amaddi25/line-follower/docs/README.md

# R4D5 Line-Following Astromech
### Collaborators: Ayush Kakkanat & Akanksha Maddi

Click [here](https://Ayush17318.github.io/line-follower/) for the website version.

This is the summarized documentation for the R4D5 robot and will discuss the process, logic, and tools used. The project was completed in a span of 5 weeks and has the following functions to execute:
- Linear line tracking
- Turn various sized curves
- Not be affected by line breaks
- Not be affected by intersections
- Avoid obstacles
- Stop in an end-zone
- Find its way back to the start-zone
  
The goal of the project was for the robot to navigate any track with the above stated elements arranged in a randomized order with sufficient speed and reliability.

The following links will discuss the hardware, electronics, software, and analysis involved with building the robot pictured below.
- [Hardware & Design](hardware-and-design.md)
- [Electronics](electronics.md)
- [Software](software.md)
- [Analysis](analysis.md)

put in naked romi and r4d5 romi photos
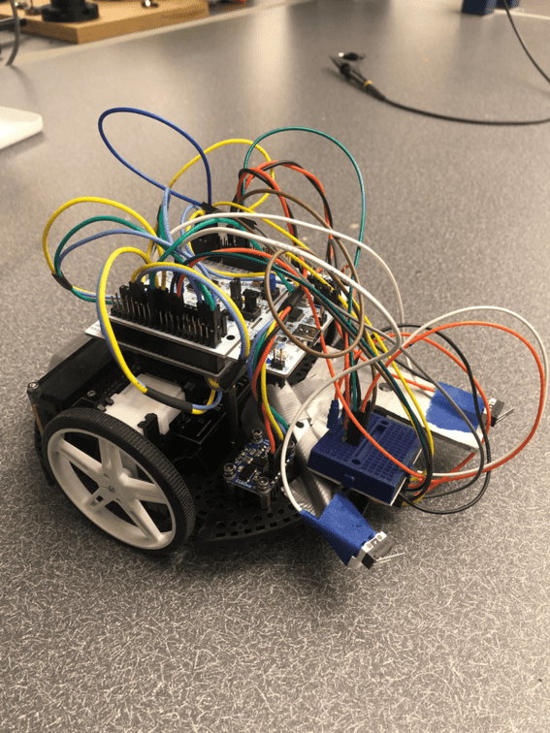
[picture p1: docs/assets/images/naked_romi.png]


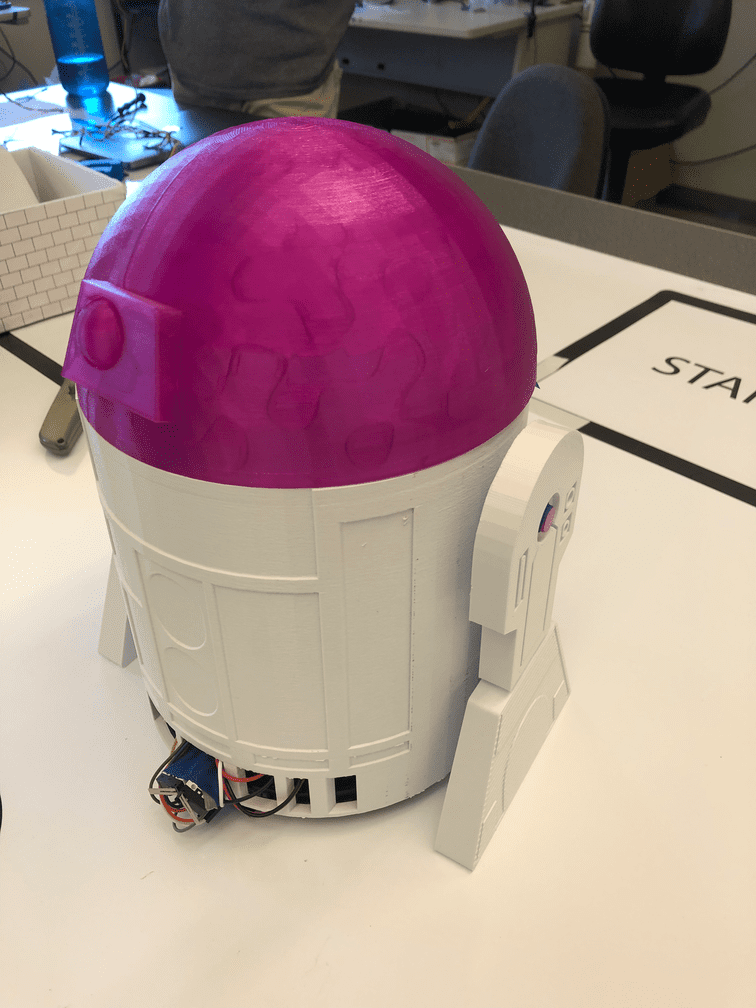
[picture p2: docs/assets/images/r4d5_isometric.png]


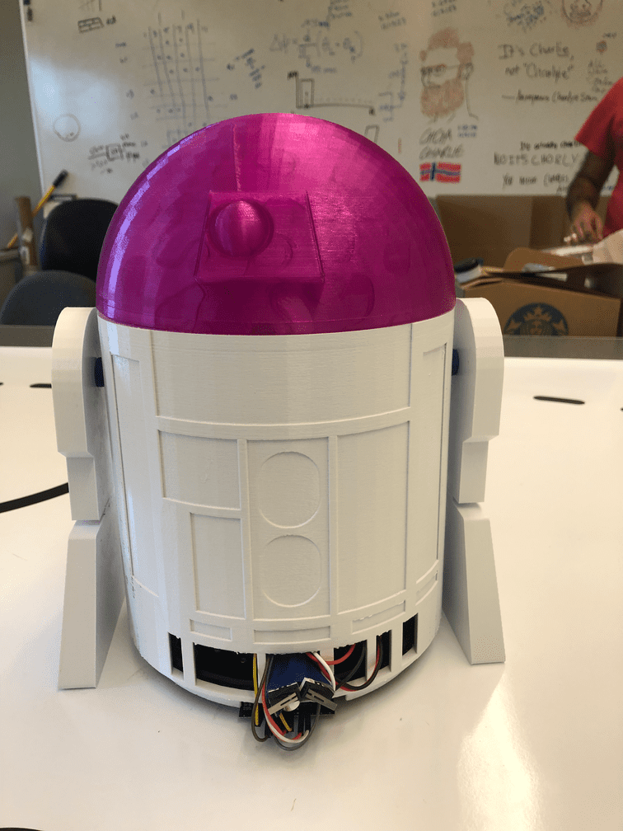
[picture p3: docs/assets/images/r4d5_front.png]


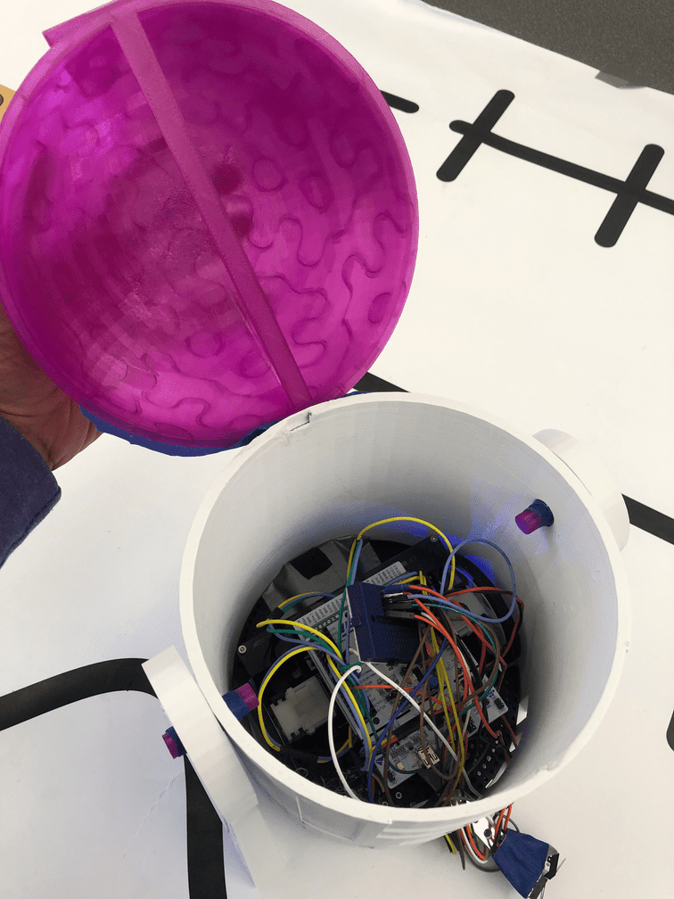
[picture p4: docs/assets/images/romi_inside_shell.png]


(Talk about how the robot was tested on two tracks as pictured)

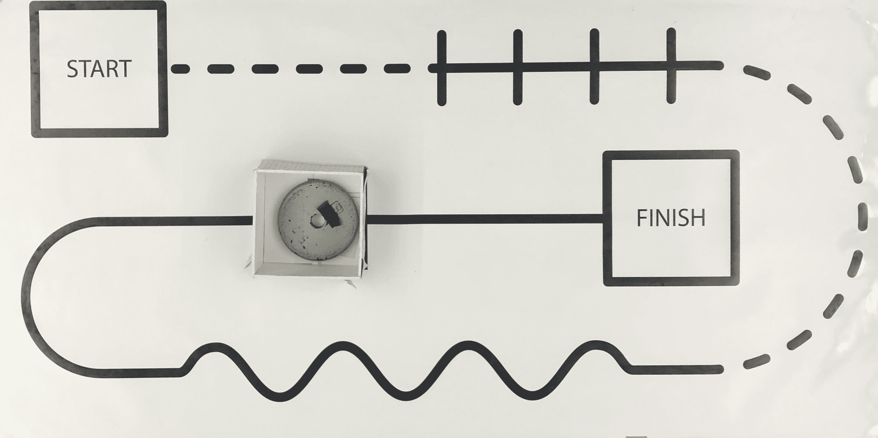
[picture p5: docs/assets/images/track1.png]


here

Final results

Video Link

https://github.com/Ayush17318/line-follower/assets/124316330/a02ead4f-ce9b-40d5-a018-f97797cce66d

Challenges

(talk about the period causing motors to pulsate and not reach the desired duty cycle, closed loop)

suggestions

talk about these
(add closed loop, use bno055 to keep track of robots absolute position and be able to find its way back to the start, get more sensors, a more robust obstacle detection algorithm using a time of flight sensor)

checklist:
finish readme
software page - doxygen, fsm, task diagram
analysis page - math
upload code
