amaddi25/line-follower/docs/software.md

# Software
## Modular Code Structure

The software serves as the intelligence center of the project, employing a modular design approach. Each class and task are meticulously organized into individual files. The main code, responsible for orchestrating the entire system, instantiates these classes and initiates the scheduler.

## Task Management

The priority multi-tasking functionality is facilitated by two essential files: cotask.py and taskshare.py, provided by Dr. JR Ridgely. The task diagram below visually represents the architecture of the software.

<p align="center">
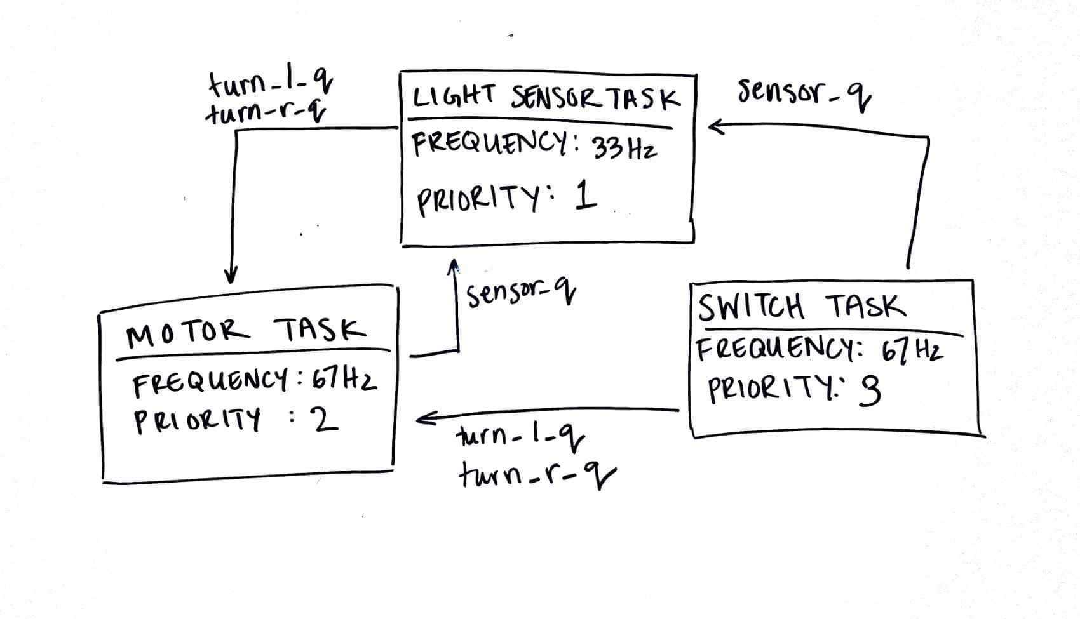
[picture p10: docs/assets/images/task_diagram.JPG]
  
</p>

## Task Prioritization and Frequency

Tasks are treated as external peripherals, either under control or providing data for analysis. Each task is assigned a priority and frequency, establishing a hierarchy in task importance. Higher priority values indicate greater significance. Tuning the period of each task through testing is crucial for optimal robot performance. For instance, motors are given higher priority and frequency compared to reflectance sensors, influencing the robot's responsiveness on the track.

## Task Intercommunication

Arrows in the task diagram represent 'queues,' enabling tasks to communicate vital information about their current state and requirements. For instance, sensor data is communicated to the motors to determine the appropriate velocity, controlling the robot's speed and direction. A limit switch communicates the proximity of obstacles, prompting the motors to adjust accordingly.

## Control Algorithm

The project operates on an open-loop control algorithm, where no attribute or variable is actively controlled or monitored for errors. Although an ideal scenario involves controlling either motor velocity or sensor data for precise line tracking, the decision was made to adopt a finite state machine (FSM) approach within an open-loop system due to the project's scope.

## Finite State Machines

### Motor Task FSM
<p align="center">
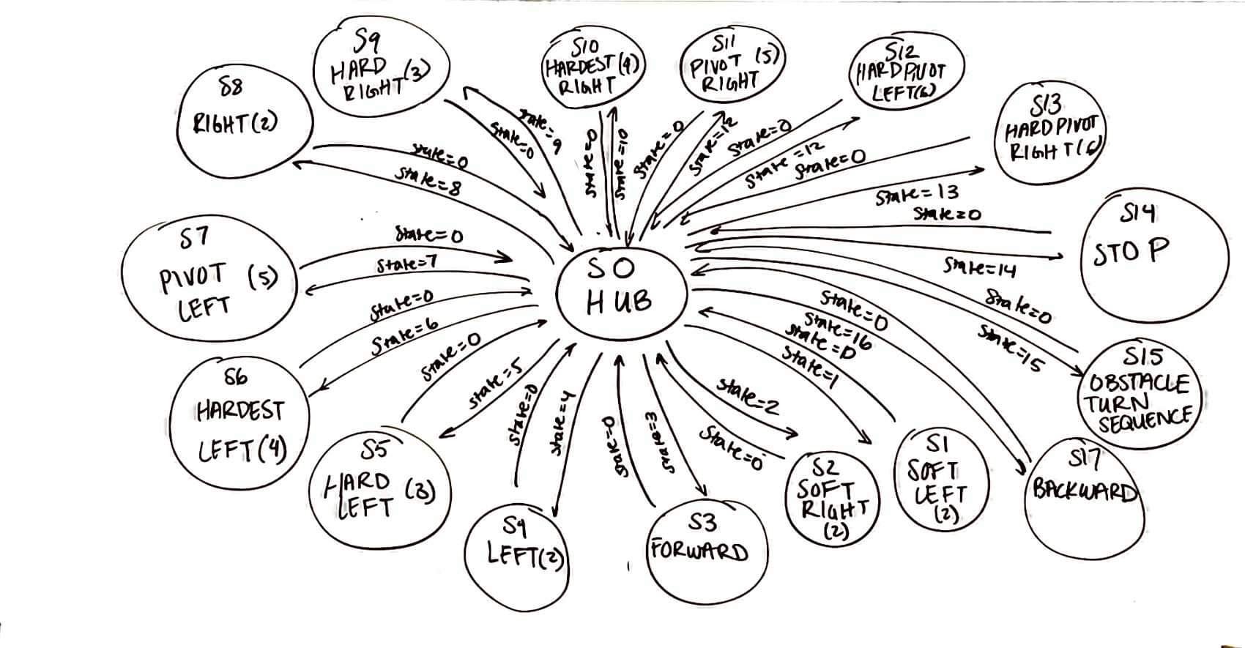
[picture p11: docs/assets/images/mot_gen_fsm.JPG]
  
</p>

(talk about it)

### Sensor Task FSM
<p align="center">
  
</p>

(talk about it)

### Switch Task FSM
<p align="center">
  
</p>

(talk about it)

## Code Documentation
Comprehensive Doxygen comments have been provided in the codebase for each Python file. The detailed documentation is accessible [here](https://ayush17318.github.io/Term-Project/).

#### [Home](./README.md)
