amaddi25/line-follower/docs/assets/solidworks/r4d5_head.SLDPRT

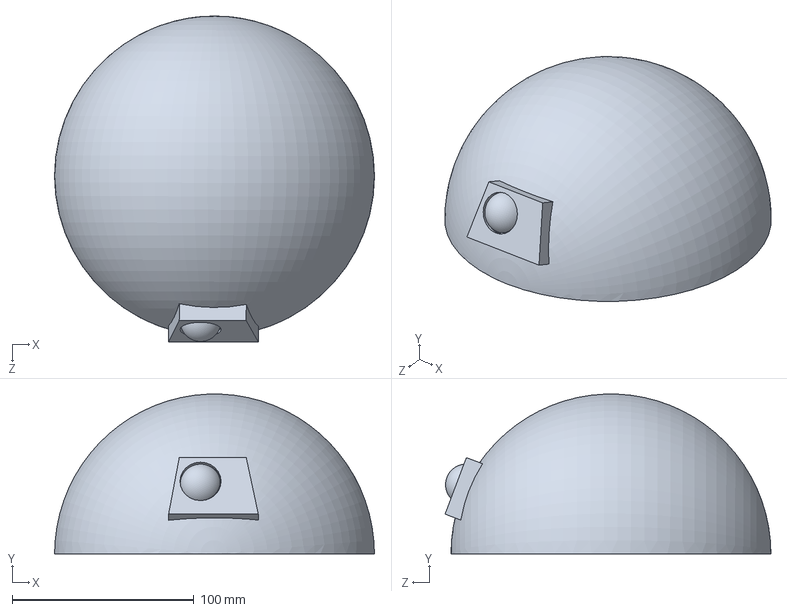
[picture p19: CAD file, 2023-12-13]
docs/assets/solidworks/r4d5_head.SLDPRT
176.2 x 88.0 x 179.5 mm
