amaddi25/line-follower/docs/assets/solidworks/r4d5_legs.SLDPRT

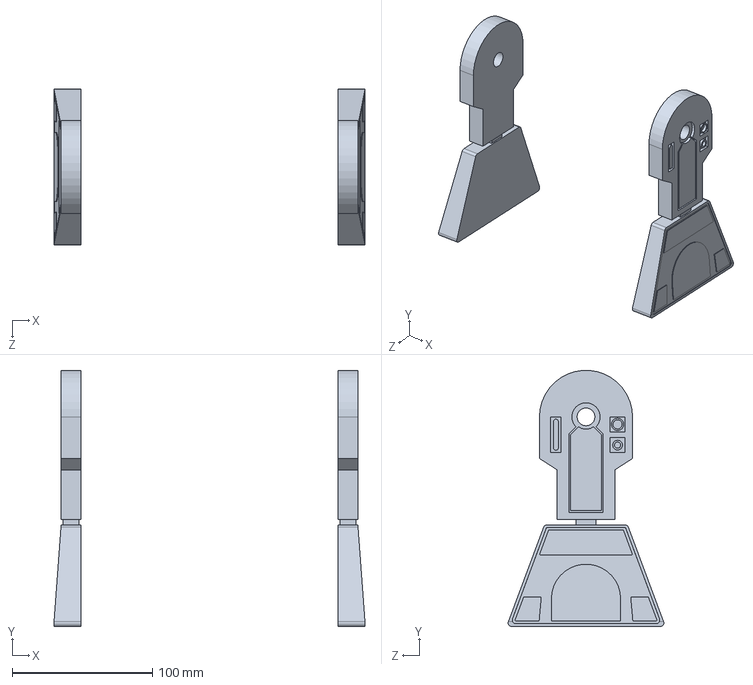
[picture p20: CAD file, 2023-12-13]
docs/assets/solidworks/r4d5_legs.SLDPRT
221.4 x 182.3 x 110.8 mm
