amaddi25/line-follower/(list of files, cad)

Other CAD files:
docs/assets/solidworks/r4d5_body.SLDPRT
docs/assets/solidworks/r4d5_Body.STL
docs/assets/solidworks/r4d5_Head.STL
docs/assets/solidworks/r4d5_Legs.STL
