amaddi25/line-follower/docs/assets/images/assembly-front.png

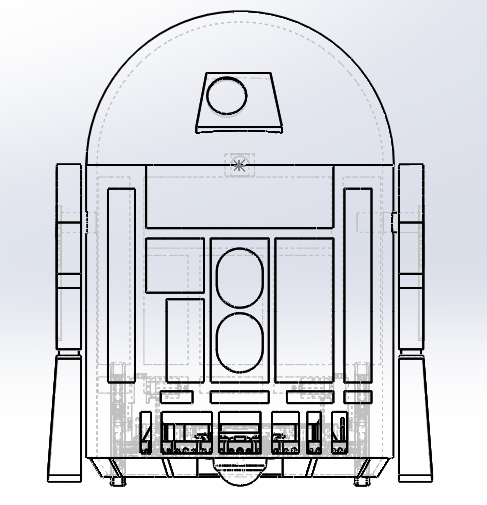
docs/assets/images/assembly-front.png
