amaddi25/line-follower/docs/assets/images/assembly-isometric.png

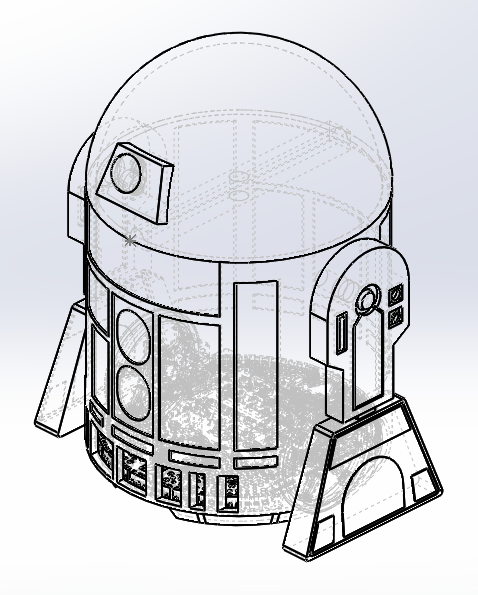
docs/assets/images/assembly-isometric.png
