amaddi25/line-follower/docs/assets/images/assembly-side.png

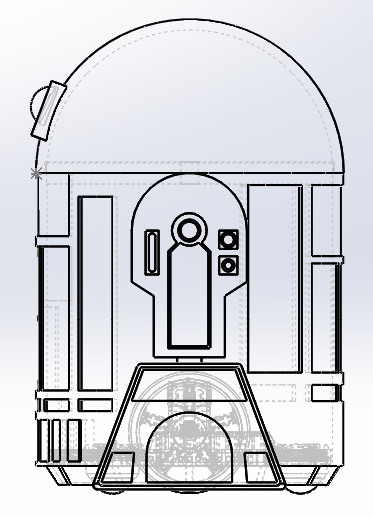
docs/assets/images/assembly-side.png
